Nobcha/R909-VFO/R909-VFO_BD.jpg

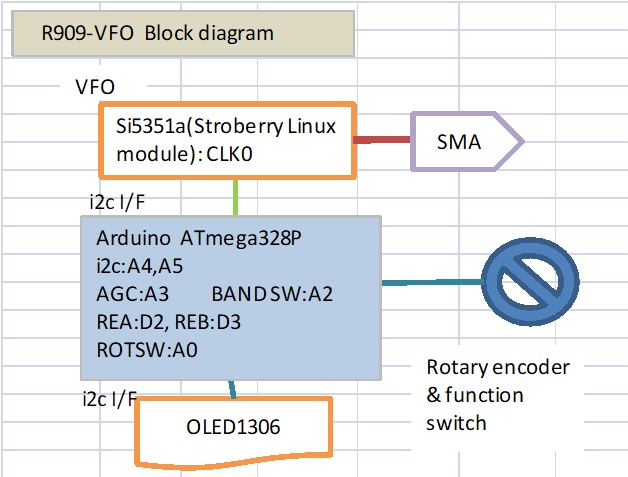
R909-VFO_BD.jpg
