Nobcha/R909-VFO/R909-VFO_scm_rev.jpg

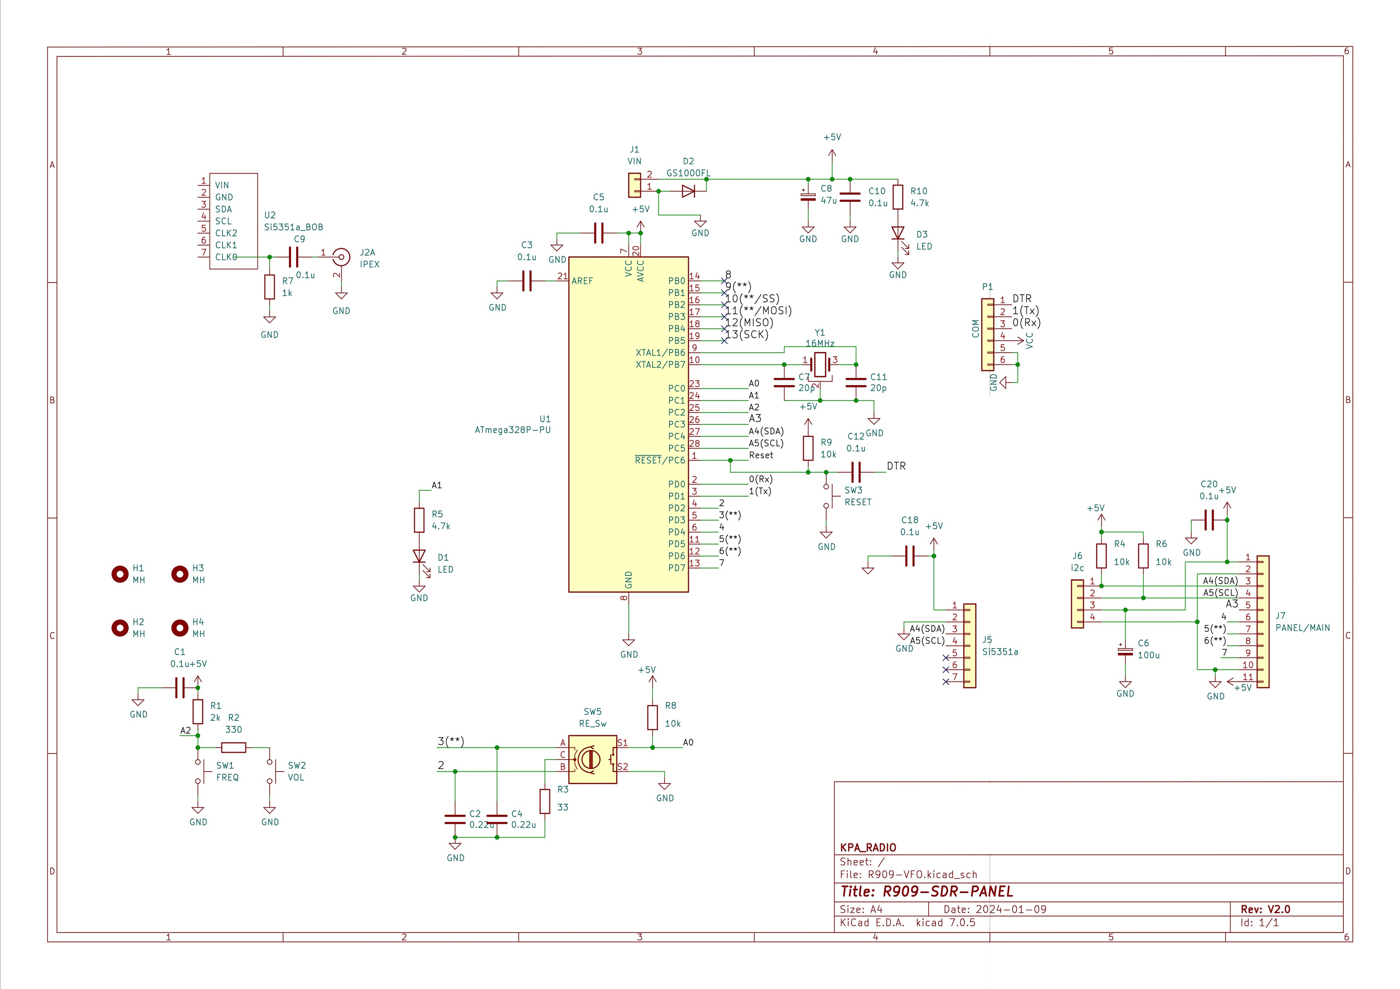
R909-VFO_scm_rev.jpg
