Nobcha/R909-VFO/R909-VFO_BOM_1_2_ja.jpg

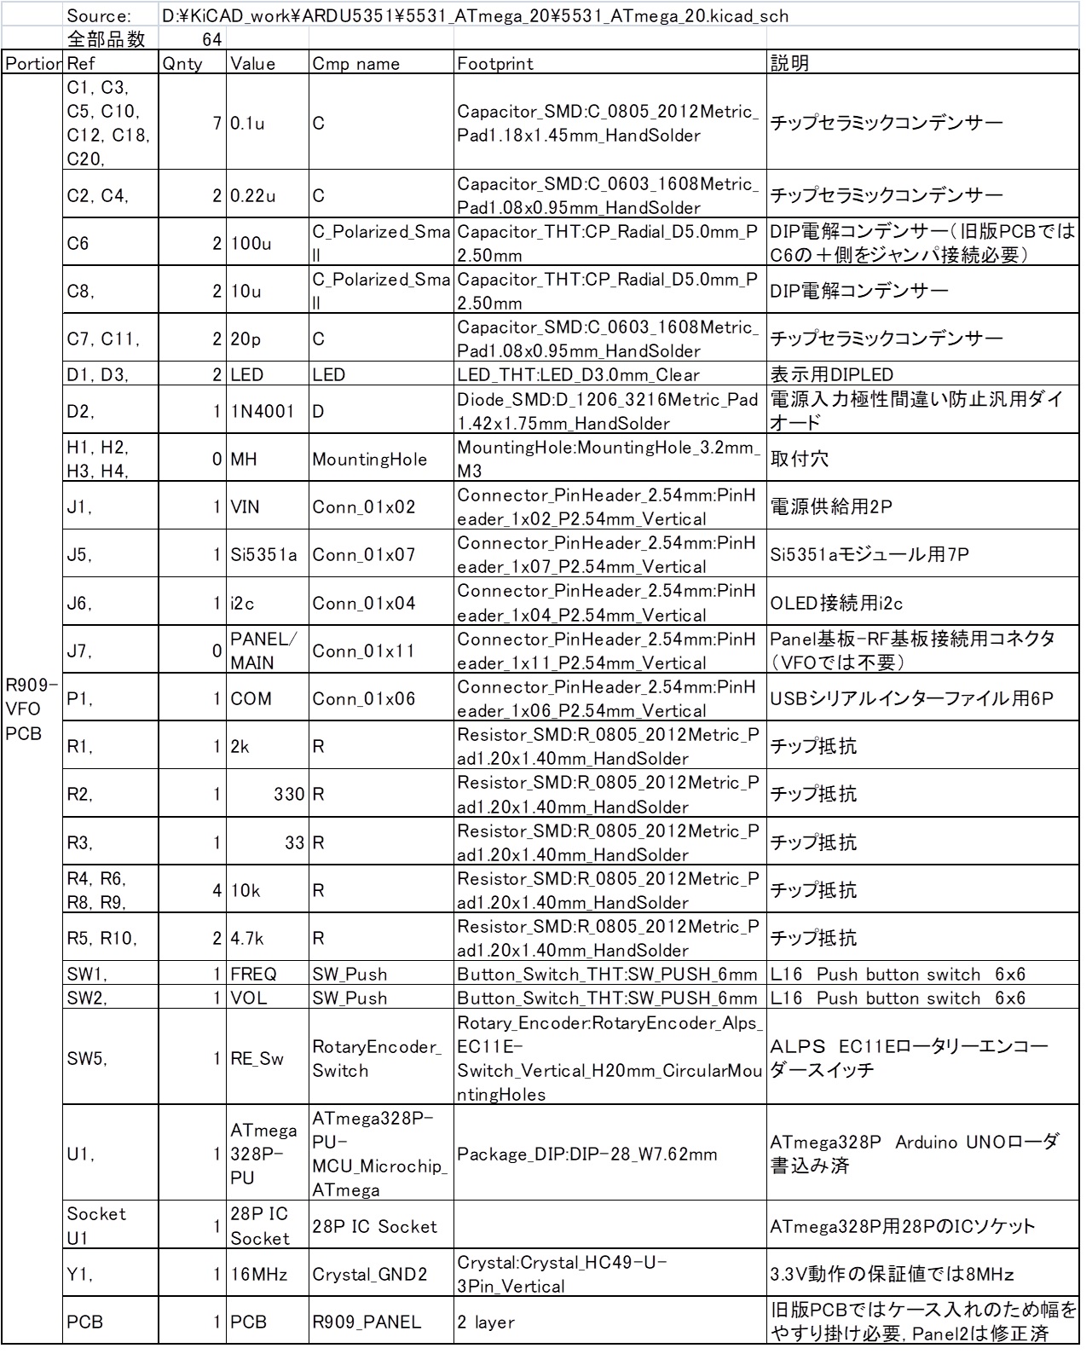
R909-VFO_BOM_1_2_ja.jpg
