Nobcha/R909-VFO/R909-VFO_BOM_en.jpg

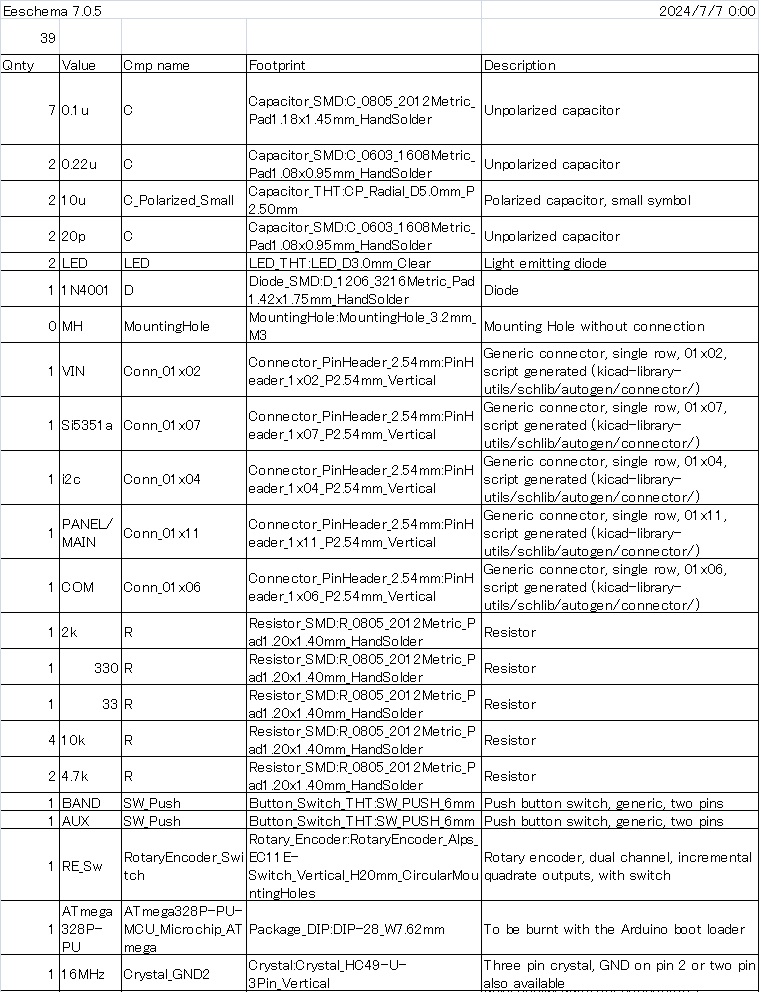
R909-VFO_BOM_en.jpg
