Nobcha/R909-VFO/R909ーVFO_Manual_ja_2.pdf

## R909-VFO 説明書 V1.2 2025.03.15 修正 （2024.08.12）

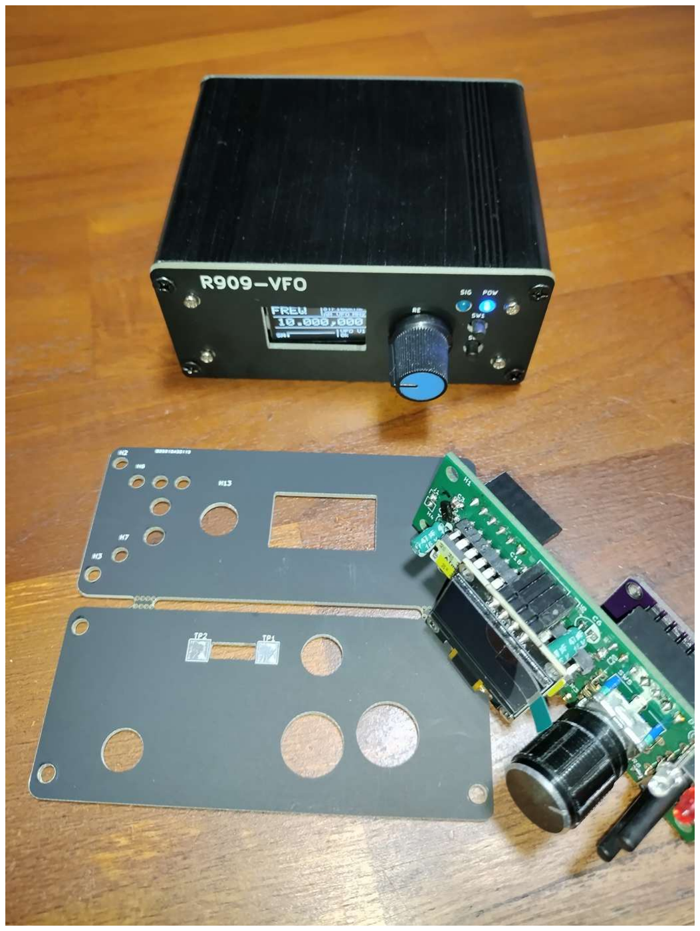
[picture p6: figure]

始めに
R909-VFO というのは R909-DSP 受信機の VFO 部を 独 立 さ せ た も の で す 。 受 信 機 の 制 御 に あ た る R909-DSP_Panel 基 板 に は Arduino UNO 搭 載 ATmega328P、OLED 表示、ロータリーエンコーダーな どのスイッチ、LED が載っており、Si5351a ストロベリーリ ナックスモジュール用のピンヘッダーも用意されています。

＃ 100ｋHz-200MHｚ、 ＃周波数増減ステップ：1Ｈｚ、 10Ｈｚ、100Ｈｚ、1ＫＨｚ、10ＫＨｚ、100ｋＨｚ，1ＭＨｚ、25ｋ Ｈｚ、＃メモリーチャンネル 50

回路構成
R909-DSP_Panel 基板に Si5351a ストロベリーリナッ クスモジュールをつなぎ、R909-DSP 受信機の Arduino のスケッチを修正し、R909-VFO をまとめました。この R909-VFO は信号発生器とか、アナログ受信機の局発デ ジタル化などに使えるようになっています。ここでは装置の 組み立て方および、試験的に使うスケッチなどについて説 明します。

構成部品について
部品表をご覧ください。必要な基板作成、部品集めを
行い、R909-DPS_Panel 基板のはんだ付け組立が 必要です。CR が表面実装のため温度制御付きはんだ
ごてを使った方が良いと思われます。また、出力用
SMA コネクタには、IPEX コネクタピグテールを使い ました。このため、Si5351a モジュールのクロック信 号端子にチップ RC と IPEX4 レセプタクルの追加が 必要になり、モジュール基板改造と追加工を行いまし
た。
基板のはんだ付けが終わったら、リチュームイオンバッ
テリー、充電回路基板、電源スイッチの配線などの部

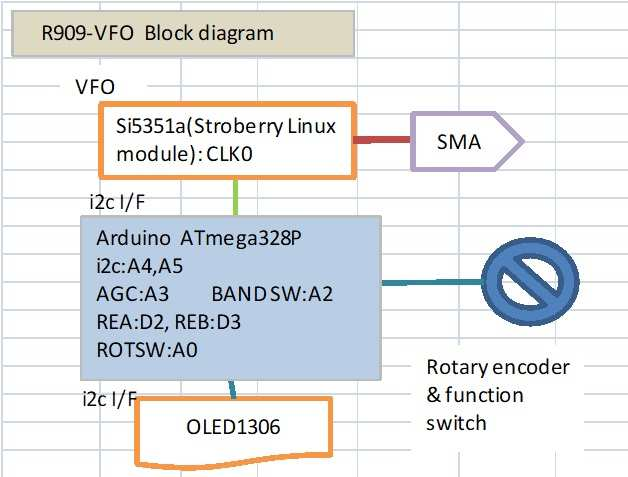
[picture p7: figure]

品を組み合わせます。
ケースとしてアルミ引き抜き材ボックス(88ｘ38ｘ70)を想定しております。このケースに入れるために基板幅を合 わせています。組立にはスペーサやねじ類が必要です。

部品表

R909 -DSP 部品表 部品表 １頁 | R909-VFO_BOM_1_2_ja.jpg
R909 -DSP 部品表 部品表 2 頁 | R909-VFO_BOM_ 2_2_ja.jpg

基板について
このプロジェクトのために設計したプリント基板
を作られる際
い。基板の
https://www.pcbgogo.jp/promo/nobcha

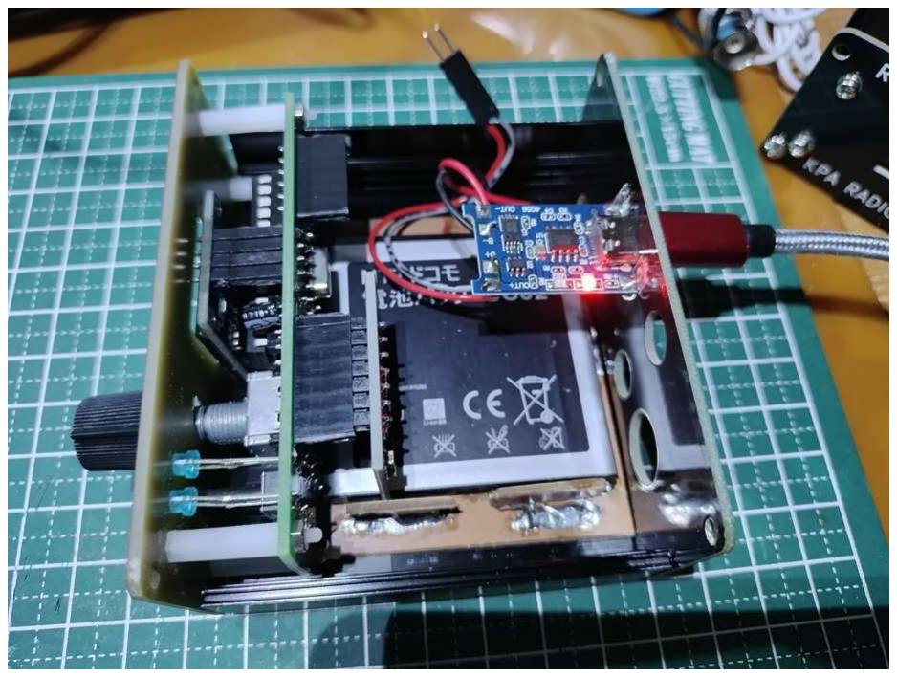
[picture p8: figure]

基板の
R909
ず背の低い部品である表面実装
けします。次に
フロントパネル穴への組み合わせを留意して
最後にスイッチ類とコネクタピンヘッダーをはんだ付
けします。
ATmega328P
IDE
シリアル接続用のピンヘッダー（

OLED
ッダー（

信号出力コネクタは
けはかなり込み入ってい
ます。

アルミケースの基板スライド部寸法の関係で、
を 0.5

ケースは

バッテリーはスマフォの使い古し品を使いました。
電回路基板は
にはんだ付け
んだ付けしても他につながることはありません。

スケッチ
組み立て
駆動し、応答があったアドレスを
レスが表示されれば、はんだ付けはほぼ成功したといえると思います。

参照

基板について
このプロジェクトのために設計したプリント基板
を作られる際、次のサイト経由で
基板のバグ修正は
https://www.pcbgogo.jp/promo/nobcha

組み立て方について
-DPS_Panel
背の低い部品である表面実装
けします。次に IC
フロントパネル穴への組み合わせを留意して
最後にスイッチ類とコネクタピンヘッダーをはんだ付

ATmega328P
とつないでデバッグの
シリアル接続用のピンヘッダー（

と Si5351a
4P と 7P

信号出力コネクタは
けはかなり込み入ってい

アルミケースの基板スライド部寸法の関係で、
0.5ｍｍ程度落とす必要があります。基板をやすりがけしてください。

88ｘ38

バッテリーはスマフォの使い古し品を使いました。
電回路基板は USB
はんだ付け固定
んだ付けしても他につながることはありません。

後の動作
駆動し、応答があったアドレスを
レスが表示されれば、はんだ付けはほぼ成功したといえると思います。

次のサイト経由で
エラッタ表を

基板のはんだ付け組立では

IC ソケットや電解コンデンサ、そして

への書き込み

モジュール
）をはんだ付けします。

SMA を用いました。
ます。

ｘ70 を使いました。

USB-C の切り抜き窓に合わせ、＋－端子部に
します。＋－端子

確認試験用

PCBGOGO
参照ください

基板のはんだ付け組立では
IC,CR

などで
必要があるときは
6P）も必要です。

用にはオスのピンヘ

を用いました。
付け外しすることをあきらめるなら、同軸ケーブルをはんだ付けしてもよいと思われ

を使いました。内蔵するバッテリーに応じ

の切り抜き窓に合わせ、＋－端子部に
を使用しま

のスケッチ、
OLED

の製作
にユーザ登録し、該当のガーバーデータにより、作成手配してくださ 。また、

、ま
をはんだ付

LED

で Arduino
USB
）も必要です。

にはオスのピンヘ

SMAメス-

R909

内蔵するバッテリーに応じ

1

すが、バックパネル基板

i2c アドレススキャナーを作りました。
に表示するというものです。

は PCBGOGO
にユーザ登録し、該当のガーバーデータにより、作成手配してくださ また、お気づきなった点が

、

-IPEX ピグテールで配線します。

-DPS_Panel

セルで保護回路が付いたものを選んで使ってください。
リード線の余りを使
すが、バックパネル基板

アドレススキャナーを作りました。

の協力を得ました。追試のためプリント基板

ピグテールで配線します。

基板（バージョン２では改善
Panel

サイズの大きい

リード線の余りを使
側の端子は独立パターンなので、そのままは

OLED

の協力を得ました。追試のためプリント基板

あれば、お教えい

IPEX

（バージョン２では改善
２基板では修正済。

88ｘ38

って、バックパネル
の端子は独立パターンなので、そのままは

ATme
のアドレス、

お教えいただけると

レセプタクルのはんだ付

したので、不要

ｘ100 もの

バックパネル

ga328P が
Si5351a モジュールのアド

幸いです

したので、不要）

も選べます

USB
USB 窓横端子

i2c アドレスを
モジュールのアド

。

の幅

。

充

実際の RF 信号を出す試験のためには CeserSound さんが Hackster に発表されている VFO のスケッチが使 えます。ポート番号を二か所修正、使用メモリーを削減したスケッチを作りました。このスケッチは 10kHz から 225MHz までの VFO として動作し、RF 信号発生器として使えます。修正したポート番号は次になります。
Changed | to | KPA-5351 | BAND | A1->A2, | rx_tx | A2->D4 | 。
i2c_scanner_R909PANEL-OLED_4732.ino

オリジナルスケッチとして、R909‐DSP 受信機スケッチを改造したものを用意しました。メモリーチャンネルやオン デ マ ン ド 周 波 数 較 正 な ど の 機 能 を 備 え た ス ケ ッ チ で す 。 機 能 や 操 作 に つ い て 以 下 説 明 し ま す 。 R909-VFO_UNIV0307.ino

注記：原因不明ですが、ロータリーエンコーダーの回転方向が開発環境により変わることがあるようです。そんな時 は REA と REB を入れ替えてください。

R909-VFO_UNIV0307.ino が提供する機能
① FUNC と下記機能が入れ替え表示するときに RE を回し機能を選びます。クリックすると各機能へ遷移します。 ② ５種の機能：FREQ:周波数設定、STEP：周波数設定時のステップ値設定、MEM：５０チャンネルの番号指定、 SCN：指定チャンネルの呼び出し、F_COR：25MHz 水晶発振回路の補正値設定
③ 各機能でダブルクリックすると、表示周波数ないしは設定値を EEPROM 書込みします。EEPROM に書き込ま れた、周波数、STEP 周波数、25MHz 水晶発振回路の補正値は電源 ON 時に呼び出します。
④ MEM 機能では EEPROM 該当チャンネルへ表示している周波数を書き込みます。
STEP で RE でのステップ値を選び、FREQ で目的周波数を設定、MEM でチャンネルを指定し、ダブルクリック します。呼び出しは SCN モードの時に RE を回し表示されたチャンネルの周波数を呼び出します。
⑤ SCN モードの時ダブルクリックするとチャンネルを順次 0.2 秒間隔でスキャンするオートスキャンモードになり ます。
⑥ F_COR機能ではSi5351aモジュールの水晶発振器25MHｚの較正値を設定します。ＲＥを回し、ＳＴＥＰ周波数 1，10，100，1000（以上は 1000 にする）単位で較正値を設定します。周波数を下げるにはマイナス方向にし ます。設定が終わったら、ダブルクリックしてＥＥＰＲＯＭに記憶させます。

⑦ 各スイッチの用途
ロータリーエンコーダー（回転）：値を増加あるいは減少させる。あるいはルーレット式にメニューを切り替える。 ロータリースイッチ（クリック）：クリックでモードを下記表のように変える。シングルとダブルがある。 SW1:FREQ モードにする。
SW2：SCN モードにする。

⑧ クリックによるモードの切り替えと機能表示など（まとめ）

Mode | FUNC select | FREQ | STEP | MEM | SCN | F_COR
表示 | FUNC と候補モ ードがフリッカす る | FREQ 周波数表示 | STEP STEP 値 | MEMｘｘ ｘ ｘ ： 00 － 49 周波数表示 | ＳＣＮｘｘ ｘ ｘ ： 00 － 49 周波数表示 | ±較正値 (-30000～ ＋30000)
ロータリ ー エ ン コ ー ダ ー （ 回 転） | [FUNC/FREQ] {FUNC/STEP} {FUNC/MEM} [FUNC/SCN] [FUNC/F_COR] | STEP 値単 位に周波数 を増減させ る | 1Hz 10Hz 100Hz 1kHz, 10ｋHz 100kHz, 1MHz, 25kHz | 記憶させ た い EEPROM の チ ャ ン ネ ル番号を増 減させる | EEPROM の チ ャ ン ネ ル番号を増 減 し 、 指 定 の周波数を 呼び出し表 示する | STEP 値単位に較 正値を増減させる (1,10,100,1000 が有効で 1000 以 上は 1000 とする)
RE-SW クリック | 各候補機能モード で行く | FUNC select モードに行く
RE-SW ダ ブ ル クリック | 無効 | EEPROM に指定値を 記憶する（電源 ON 時に 呼び出される） | | 指 定 チ ャ ン ネ ル EEPROM に周波数を 記憶する | 自 動 チ ャ ン ネ ル ス キ ャ ン モ ー ド に 入る | EEPROM に指定 値を記憶する（電源 ON 時に呼び出さ れる）

F_COR で扱う較正値は Si5351a の水晶発振回路 25MHz に対しての補正値です。
RE-SW を押しながら電源 ON を入れると EEPROM の値が初期化(周波数 10Mhz、STEP100kHz) します。 ATmega328P へ初めてスケッチを書き込んで使うときには EEPROM 初期化をお勧めしま す。

また、この VFO を利用したアナログ受信機のデジタル化局発化改造を今後もやってみるつもりです。出来上がった 際に追加していきます。

今後の情報提供は「nobcha23 のエアバンド受信機自作ブログ DIY airband receiver BLOG」において行っ ていきます。https://nobcha23.hatenadiary.com/

GITHUB アップロードファイル
https://github.com/Nobcha/R909-VFO/
項 番 | ファイルの説明 | ファイル名
1 | R909-VFO 取り扱い説明書（日本語版） | R909ーVFO_Manual_ja_2.pdf ＊2
2 | R909-VFOtechnical manual （ English edition） | R909ーVFO_Manual_en_１.pdf
3 Gerber file of the R909-DSP_Panel PCB 回 | 路基板ガーバー | 5531_ATm_25.kicad_pcb.zip
4 | Gerber file of the R909-DSP_front-back-panel PCB 前後パネ ル | front-back-p.kicad_pcb.zip
5 i2c address scanner sketch シリアルポートと | OLED に表示 | i2c_scanner_R909PANEL-OLED_4732.ino
6 10kHz to 225MHz VFO 移 植 (originally | CesarSound made) | Changed to KPA-5351 sketch.txt
7 R909-DSP のスケッチの移植、100ｋHz-200MH | ｚ、50ｃｈメモリー | R909-VFO_UNIV0307.ino ＊1
8 | 回路図 | R909-VFO_scm_rev.jpg
9 | R909-DSP 部品表 １頁 | R909-VFO_BOM_1_2_ja.jpg
10 | R909-DSP 部品表 2 頁 | R909-VFO_BOM_2_2_ja.jpg
11 | PCB のエラッタ（修正事項） | R909-VFO_errata.jpg

＊1 2025.03.07 改善・修正を行いました。
＊2 2025.03.15 修正を行いました。

追試に伴う注意事項と情報提供感謝
この回路、試作は nobcha(JA3KPA)が自身の興味と利用のために実施したものです。出来上がりや動作につい て結果を保証するものではありません。基板の製造、組立やはんだ付けにはそれなりの知識や技能や機材などが必 要です。回路図を理解し、部品表の内容がお分かりになった上で追試されたら良いと思います。
回路や Arduino スケッチは WEB などに紹介されている先駆者の情報を参考にしています。それらの情報提供に 感謝いたします。できる限り引用元を明記しております。お気づきの点あればお教えください。また、本試作の基板、 スケッチなどには著作権があります。
