Nobcha/R909-VFO/R909ーVFO_Manual_ja.pdf

R909-VFO 説明書 | V1.1 2024.08.12


外観写真

始めに
R909-VFO というのは R909-DSP 受信機の VFO 部を独立させたものです。R909-DSP 受信機の VFO 部である R909-DSP_Panel 基板には Arduino UNO 搭載 ATmega328P、OLED 表示、ロータリーエンコーダーなどのスイッチ、LED が載っており、Si5351a ストロベリーリナックスモジュール用のピンヘッダーも用意されています。

＃ 100ｋHz-225MHｚ、 ＃周波数増減ステップ：10Ｈｚ、1ＫＨｚ、100ｋＨｚ，1ＭＨｚ、10ＭＨｚ、25ｋＨｚ、＃メモリーチャンネル 50

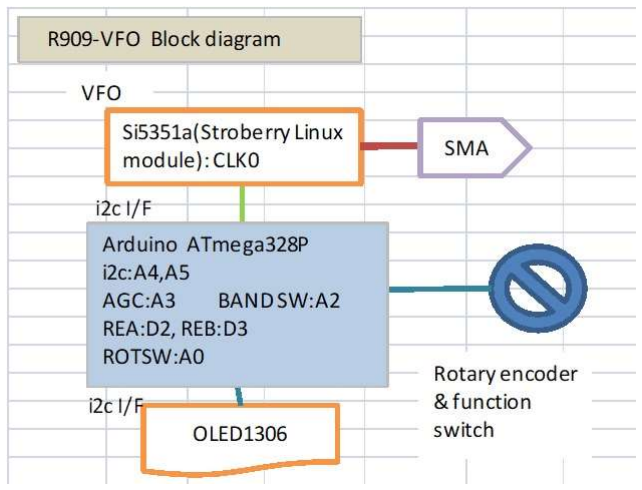
[picture p17: figure]

ブロックダイヤグラム

回路構成
R909-DSP_Panel 基板に Si5351a ストロベリーリナックスモジュール
修正し、R909-VFO をまとめました。この R909 ようになっています。ここでは装置の組み立て方および、試験的に使うスケッチなどについて説明します。


内部写真

構成部品について
まずは部品表をご覧ください。まず一番、
温度制御付きはんだごてを使った方が良いと思われます。また、
IPEX4 レセプタクルの追加が必要であり、モジュール基板改造が必要になります。 基板のはんだ付けの他にはリチュームイオンバッテリー、充電回路基板、電源スイッチの配線も部品に合わせ必要にな ります。
部品を組み合わせてケースに入れるには

ストロベリーリナックスモジュールをつなぎ、R909-DSP 受信機の
R909-VFO は信号発生器とか、アナログ受信機の局発デジタル化などに使える 。ここでは装置の組み立て方および、試験的に使うスケッチなどについて説明します。

R909-DPS_Panel 基板のはんだ付け組立が必要です。 Si5351a モジュールでは

リチュームイオンバッテリー、充電回路基板、電源スイッチの配線も部品に合わせ必要にな

、スペーサやねじ類が必要です。

受信機の Arduino のスケッチを

CR が表面実装のため
クロック信号にチップ RC と

部品表参照

R909-DSP 部品表 １頁 | R909-VFO_BOM_1_2_ja.jpg
R909-DSP 部品表 2 頁 | R909-VFO_BOM_2_2_ja.jpg

基板について
このプロジェクトのために設計したプリント基板試作の製作は PCBGOGO の協力を得ました。追試のためプリント基板を 作られる際、次のサイト経由で PCBGOGO にユーザ登録し、該当のガーバーデータにより、作成手配してください。 https://www.pcbgogo.jp/promo/nobcha

基板の組み立て方について
R909-DPS_Panel 基板のはんだ付け組立では、まず背の低い部品である表面実装 IC,CRをはんだ付けします。次に ICソ ケットや電解コンデンサ、そしてフロントパネル穴への組み合わせを留意して LED、最後にスイッチ類とコネクタピンヘッ ダーをはんだ付けします。
ATmega328P への書き込みなどで Arduino IDE とつないでデバッグの必要があるときは USB シリアル接続用のピンヘッ ダー（6P）も必要です。

OLED と Si5351a モジュール用にはオスのピンヘッダー（4P と 7P）をはんだ付けします。

信号出力コネクタは SMA を用いました。SMA メス-IPEX ピグテールで配線します。IPEX レセプタクルのはんだ付けはか なり込み入っています。付け外しすることをあきらめるなら、同軸ケーブルをはんだ付けしてもよいと思われます。

アルミケースの基板スライド部の寸法の関係で、R909-DPS_Panel基板（バージョン２では改善したので、不要）の幅を 0.5 ｍｍ程度落とす必要があります。基板をやすりがけしてください。Panel２基板では修正済。

ケースは 88ｘ38ｘ70 を使いました。内蔵するバッテリーに応じサイズの大きい 88ｘ38ｘ100 ものも選べます。

バッテリーはスマフォの使い古し品を使いました。1 セルで保護回路が付いたものを選んで使ってください。USB 充電回 路基板は USB-C の切り抜き窓に合わせ、＋－端子部にリード線の余りを使って、バックパネル USB 窓横端子にはんだ 付け固定します。＋－端子を使用しますが、バックパネル基板側の端子は独立パターンなので、そのままはんだ付けし ても他につながることはありません。

スケッチ

組み立て確認のために試験用のスケッチ、i2c アドレススキャナーを作りました。ATmega328P が i2c アドレスを駆動し、 応答があったアドレスをOLEDに表示するというものです。OLED自身のアドレス、Si5351aモジュールのアドレスが表示さ れれば、はんだ付けはほぼ成功したといえると思います。

実際に RF 信号を出す試験のために CeserSound さんが Hackster に発表されている VFO のスケッチが使えます。ポート 番号を二か所修正、使用メモリーを削減したスケッチを作りました。このスケッチは 10kHz から 225MHz までの VFO とし て動作し、RF 信号発生器として使えます。修正したポート番号は次になります。Changed to KPA-5351 BAND A1->A2, rx_tx A2->D4。

オリジナルのスケッチとして、開発のベースになった R909‐DSP 受信機スケッチを改造し、メモリーチャンネルやオンデマ ンド周波数較正などの機能を備えたスケッチを用意しました。R909-VFO_sketch_0628.zip

また、この VFO を利用しアナログ受信機のデジタル化局発化改造を今後もやってみるつもりです。出来上がった際に追 加していきます。

今後の情報提供は「nobcha23 のエアバンド受信機自作ブログ DIY airband receiver BLOG」において行ってい

### きます。https://nobcha23.hatenadiary.com/

GITHUB アップロードファイル
https://github.com/Nobcha/R909-VFO/
項番 | ファイルの説明 | ファイル名
1 | R909-VFO 取り扱い説明書（日本語版） | R909ーVFO_Manual_ja.pdf
2 | R909-VFOtechnical manual（English edition） | R909ーVFO_Manual_en.pdf
3 | Gerber file of the R909-DSP_Panel PCB 回路基板ガーバー | 5531_ATm_25.kicad_pcb.zip
4 | Gerber file of the R909-DSP_front-back-panel PCB 前後パネル | front-back-p.kicad_pcb.zip
5 | i2c address scanner sketch シリアルポートと OLED に表示 | i2c_scanner_R909PANEL-OLED_4732.ino
6 | 10kHz to 225MHz VFO 移植 (originally CesarSound made) | Changed to KPA-5351 sketch.txt
7 | R909-DSP のスケッチの移植、100ｋHz-225MHｚ、50ｃｈメモリー | R909-VFO_sketch_0628.zip
8 | 回路図 | R909-VFO_scm_rev.jpg
9 | R909-DSP 部品表 １頁 | R909-VFO_BOM_1_2_ja.jpg
10 | R909-DSP 部品表 2 頁 | R909-VFO_BOM_2_2_ja.jpg
11 | PCB のエラッタ（修正事項） | R909-VFO_errata.jpg

追試に伴う注意事項と情報提供感謝
この回路、試作は nobcha(JA3KPA)が自身の興味と利用のために実施したものです。出来上がりや動作について結果 を保証するものではありません。基板の製造、組立やはんだ付けにはそれなりの知識や技能や機材などが必要です。 回路図を理解し、部品表の内容がお分かりになった上で追試されたら良いと思います。
回路や Arduino スケッチは WEB などに紹介されている先駆者の情報を参考にしています。それらの情報提供に感謝い たします。
