Nobcha/R909-VFO/R909-VFO_errata.jpg

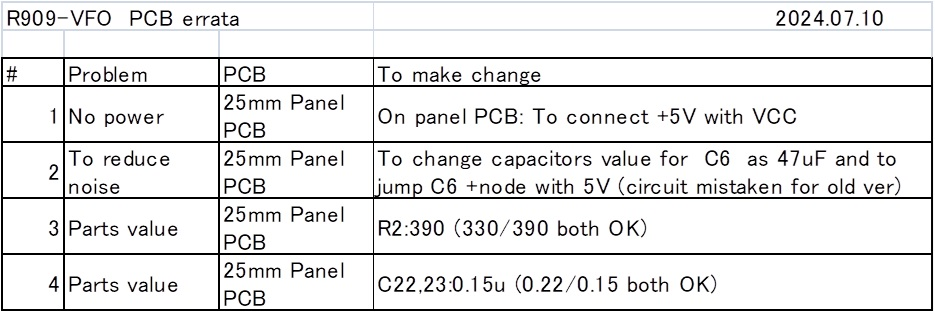
R909-VFO_errata.jpg
