Nobcha/R909-VFO/(commit log)

2024-06-03 Update README.md
    Introduction to R909-VFO design and assembling.
2024-06-04 Update README.md
    日本語版
2024-06-05 Update README.md
    説明追加
2024-06-28 Arduino sketch
    This was diverted from R909-DSP.
2024-08-03 The front/back panel PCB Gerber data
    The integrated PCB pattern Gerber data with the front and back panel
2024-08-03 panel PCB Gerber
2025-03-09 Add files via upload
    日本語版の説明書を改訂しました。また、間違ったスケッチをアップロードしておりましたので、修正したスケッチをアップロードするとともにスケッチの操作説明を追記しました。
2025-03-09 Add files via upload
    The latest sketch for 100kHz-200Mhz VFO. Which is included 50 channels memories and Si5351a oscillator correction.
    [R909-VFO_UNIV0307.ino]
